RA2PS/Radio-Telescope-RAPS/README.md

# Radio-Telescope-RCA
Radio Telescope System for 1 GHz to 2 GHz Operation

> [!important]
> Make sure to add a KiCad path variable named "RADIO_TELESCOPE_RAPS_PATH"
> for the symbols and footprint to be found on your machine.
