RA2PS/Radio-Telescope-RAPS/KiCad PCB-Schematic/RCA Radio Telescope (MultiPCB)/KiKit Exports/RF Boards/MDF_PCB_Rev1-3/Models/142-0711-821.stp

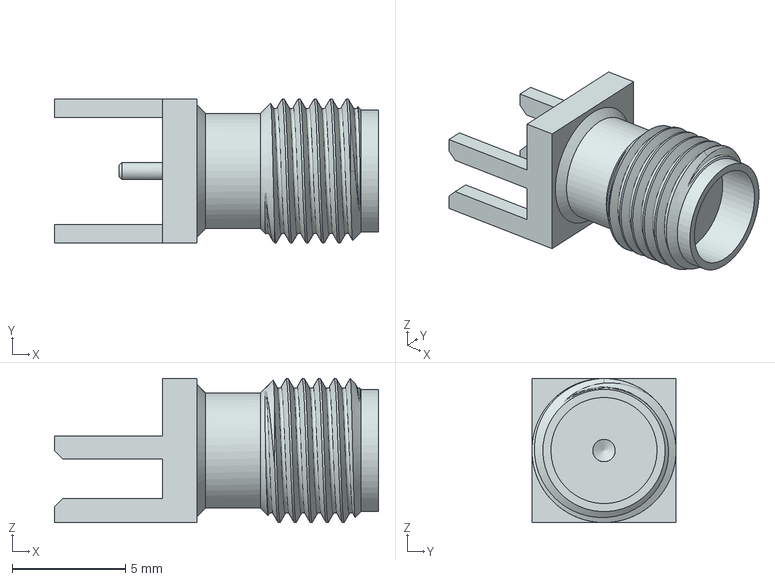
[picture p1: CAD file, 2026-05-28]
KiCad PCB-Schematic/RCA Radio Telescope (MultiPCB)/KiKit Exports/RF Boards/MDF_PCB_Rev1-3/Models/142-0711-821.stp
14.3 x 6.35 x 6.35 mm
