RA2PS/Radio-Telescope-RAPS/KiCad PCB-Schematic/RCA Radio Telescope (MultiPCB)/KiKit Exports/RF Boards/MDF_PCB_Rev1-3.step

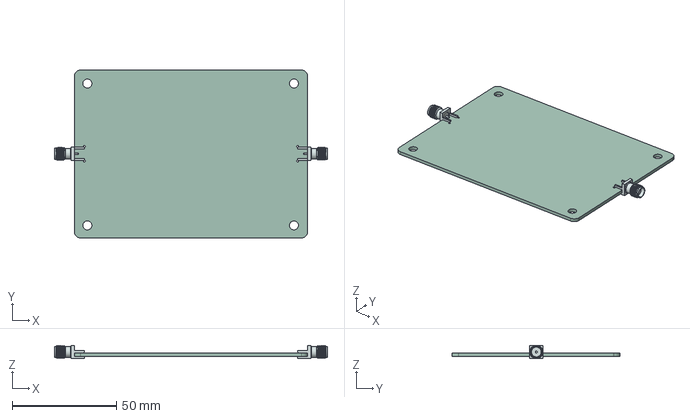
[picture p3: CAD file, 2026-05-28]
KiCad PCB-Schematic/RCA Radio Telescope (MultiPCB)/KiKit Exports/RF Boards/MDF_PCB_Rev1-3.step
130.8 x 80.5 x 6.35 mm
MDF_PCB_Rev1-3_PCB
