RA2PS/Radio-Telescope-RAPS/KiCad PCB-Schematic/RCA Radio Telescope (MultiPCB)/Models/SC-70_C5_MCH.step

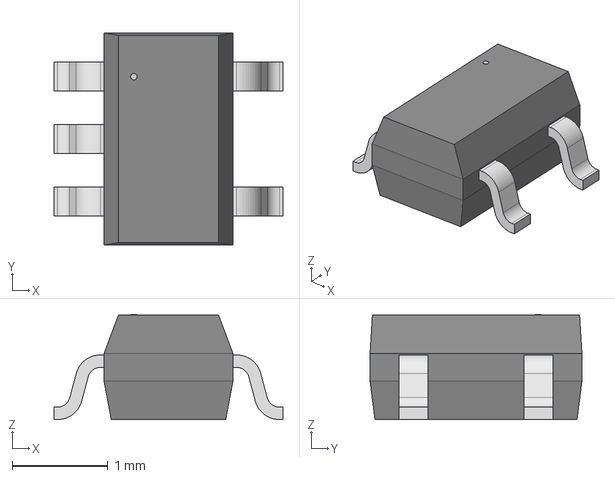
[picture p4: CAD file, 2026-05-28]
KiCad PCB-Schematic/RCA Radio Telescope (MultiPCB)/Models/SC-70_C5_MCH.step
2.39 x 2.21 x 1.09 mm
