RA2PS/Radio-Telescope-RAPS/KiCad PCB-Schematic/RCA Radio Telescope (MultiPCB)/KiKit Exports/RF Boards/MSF_PCB_Rev1-3.step

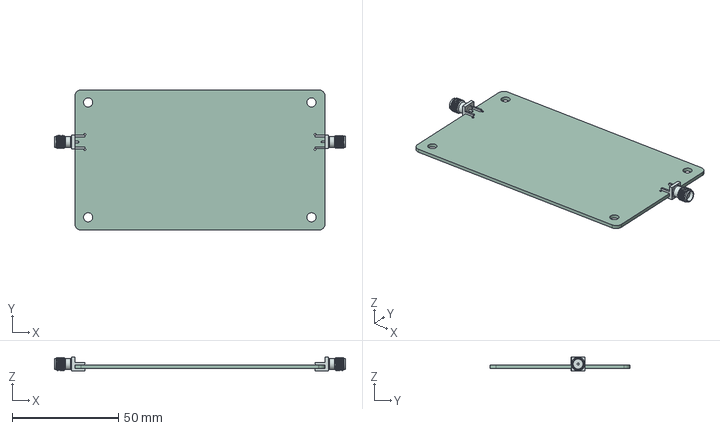
[picture p5: CAD file, 2026-05-28]
KiCad PCB-Schematic/RCA Radio Telescope (MultiPCB)/KiKit Exports/RF Boards/MSF_PCB_Rev1-3.step
136.8 x 66.0 x 6.35 mm
MSF_PCB_Rev1-3_PCB
