RA2PS/Radio-Telescope-RAPS/KiCad PCB-Schematic/RCA Radio Telescope (MultiPCB)/KiKit Exports/RF Boards/RFS_PCB_Rev1-4.step

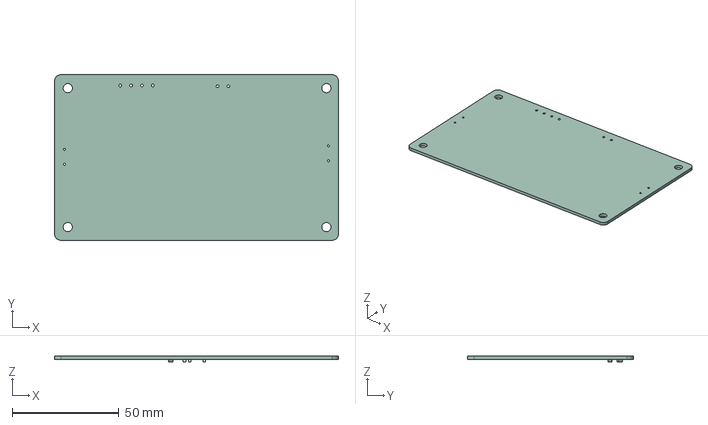
[picture p7: CAD file, 2026-05-28]
KiCad PCB-Schematic/RCA Radio Telescope (MultiPCB)/KiKit Exports/RF Boards/RFS_PCB_Rev1-4.step
132.9 x 77.5 x 2.90 mm
C_0805_2012Metric x 4
_autosave-RFS_PCB_Rev1-4_PCB
