RA2PS/Radio-Telescope-RAPS/KiCad PCB-Schematic/RCA Radio Telescope (MultiPCB)/Models/SMB_DIO.step

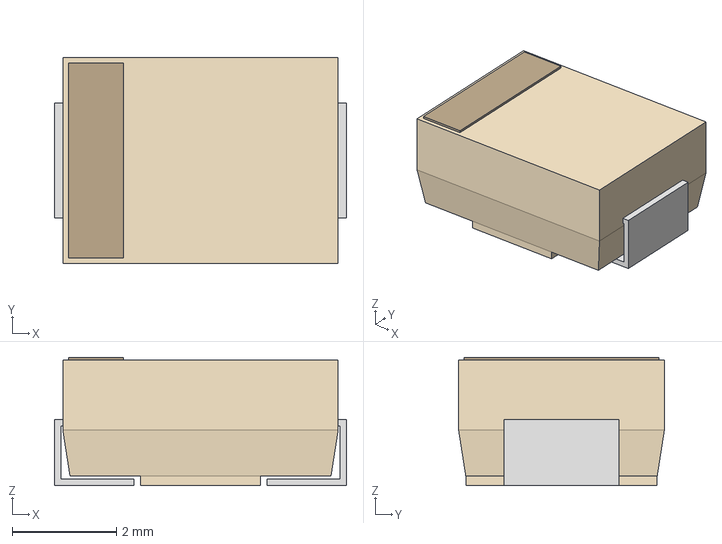
[picture p8: CAD file, 2026-05-28]
KiCad PCB-Schematic/RCA Radio Telescope (MultiPCB)/Models/SMB_DIO.step
5.59 x 3.94 x 2.45 mm
