RA2PS/Radio-Telescope-RAPS/KiCad PCB-Schematic/RCA Radio Telescope (MultiPCB)/Models/MIC5365-1.8YC5-TR.step

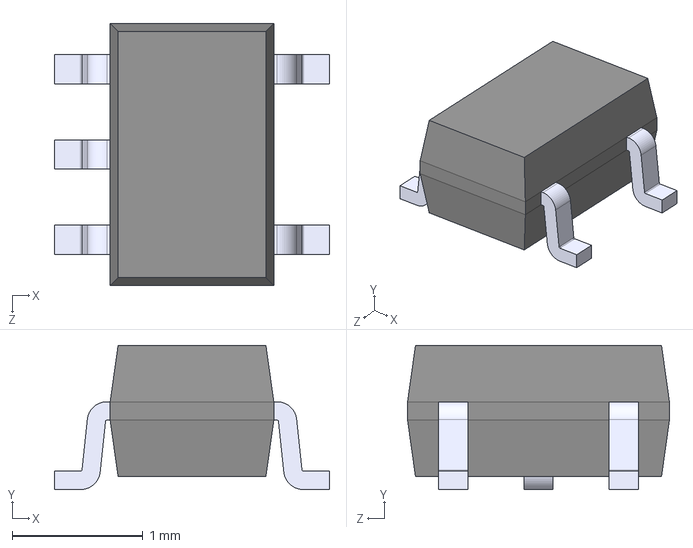
[picture p9: CAD file, 2026-05-28]
KiCad PCB-Schematic/RCA Radio Telescope (MultiPCB)/Models/MIC5365-1.8YC5-TR.step
2.10 x 1.10 x 2.00 mm
