RA2PS/Radio-Telescope-RAPS/KiCad PCB-Schematic/RCA Radio Telescope (MultiPCB)/Models/IND_CB_DRA73.step

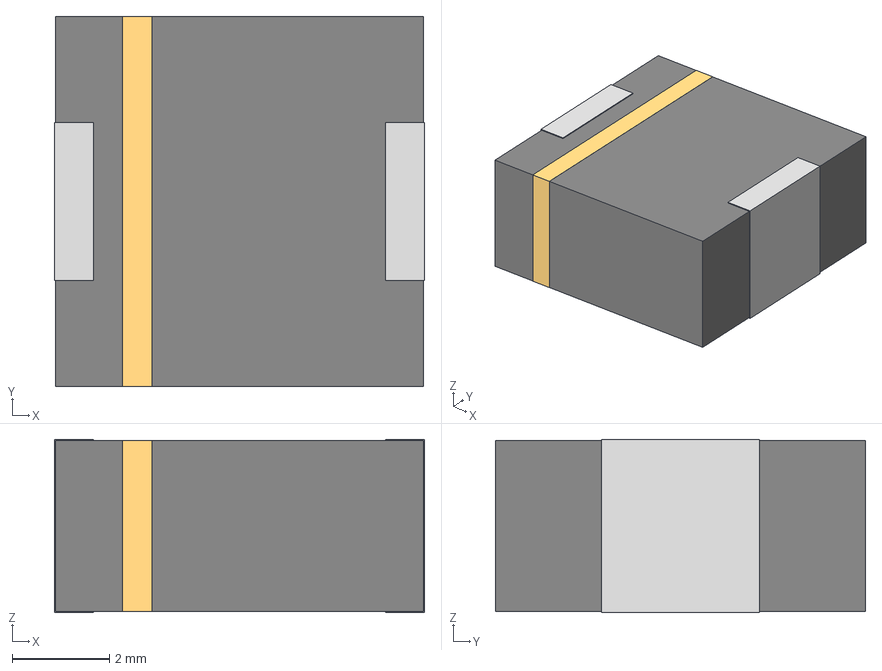
[picture p10: CAD file, 2026-05-28]
KiCad PCB-Schematic/RCA Radio Telescope (MultiPCB)/Models/IND_CB_DRA73.step
7.59 x 7.60 x 3.56 mm
