RA2PS/Radio-Telescope-RAPS/KiCad PCB-Schematic/RCA Radio Telescope (MultiPCB)/Models/MAX8510EXK30T.step

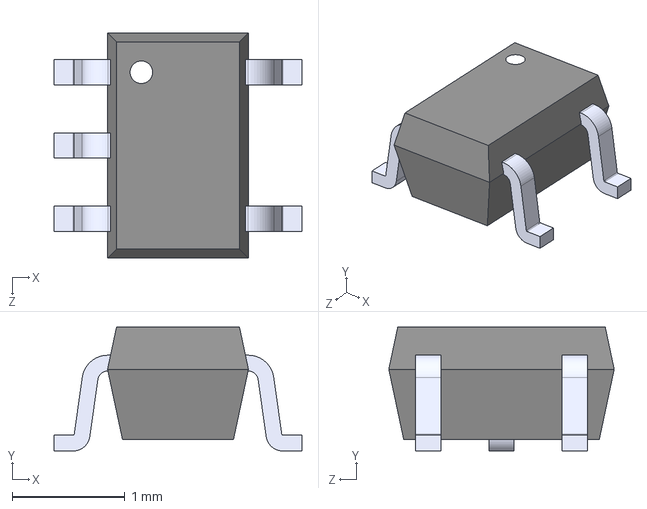
[picture p11: CAD file, 2026-05-28]
KiCad PCB-Schematic/RCA Radio Telescope (MultiPCB)/Models/MAX8510EXK30T.step
2.20 x 1.10 x 2.00 mm
