RA2PS/Radio-Telescope-RAPS/KiCad PCB-Schematic/RCA Radio Telescope (MultiPCB)/Models/RGT0016C.stp

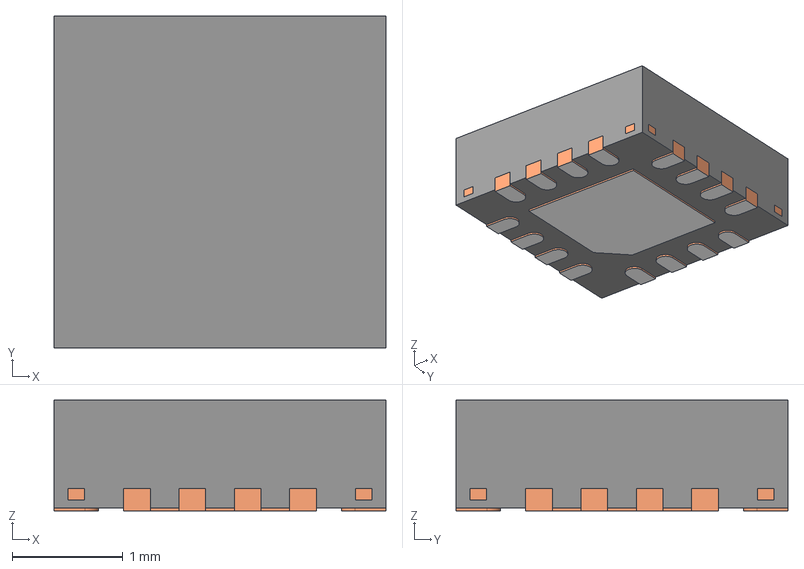
[picture p12: CAD file, 2026-05-28]
KiCad PCB-Schematic/RCA Radio Telescope (MultiPCB)/Models/RGT0016C.stp
3.00 x 3.00 x 1.00 mm
BODY-QFN
FRAME-RGT0016C
PIN1-ID
