RA2PS/Radio-Telescope-RAPS/KiCad PCB-Schematic/RCA Radio Telescope (MultiPCB)/Models/DFN2020E-6_STP.STP

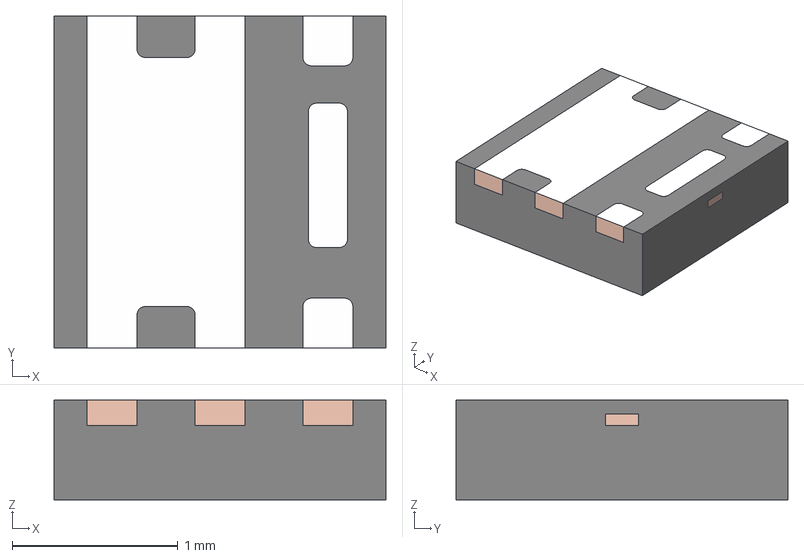
[picture p13: CAD file, 2026-05-28]
KiCad PCB-Schematic/RCA Radio Telescope (MultiPCB)/Models/DFN2020E-6_STP.STP
2.00 x 2.00 x 0.6 mm
Coumpound
LF
