RA2PS/Radio-Telescope-RAPS/(list of files, cad)

Other CAD files:
KiCad PCB-Schematic/RCA Radio Telescope (MultiPCB)/KiKit Exports/RF Boards/RFS_PCB_Rev1-3/Models/1729144.stp
KiCad PCB-Schematic/RCA Radio Telescope (MultiPCB)/Models/1729144.stp
