RA2PS/Radio-Telescope-RAPS/KiCad/smd_filter/smd_filter.kicad_pcb

## KiCad design KiCad/smd_filter/smd_filter.kicad_pcb (2026-10-02)

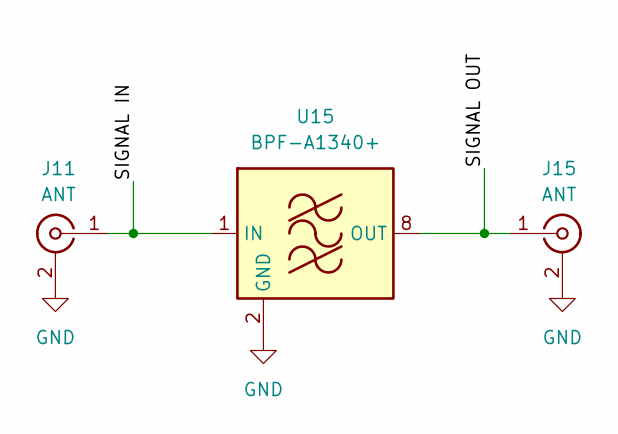
[picture p15: schematic smd_filter.kicad_sch]

Parts:
J11, J15: ANT; CONN_142-0711-821_CIN
U15: BPF-A1340+; Mini-Circuits_HQ1157

Connections:
/SMDFilter/GND: J11.2 (Ext), J15.2 (Ext), U15.2 (GND), U15.3 (GND), U15.4 (GND), U15.5 (GND), U15.6 (GND), U15.7 (GND), U15.9 (GND), U15.10 (GND), U15.11 (GND), U15.12 (GND), U15.13 (GND), U15.14 (GND)
/SMDFilter/SIGNAL_IN: J11.1 (In), U15.1 (IN)
/SMDFilter/SIGNAL_OUT: J15.1 (In), U15.8 (OUT)

Board: 2 copper layers, 3 parts (0 on the bottom side), 3 nets, no tracks yet.
