RA2PS/Radio-Telescope-RAPS/(commit log)

2026-05-28 Move BOM to a subdirectory and delete datasheets
    [Bill of Materials.xlsx]
2026-05-28 Copy each board to its own KiCad project
    [matched_distributive_filter.kicad_pcb, matched_distributive_filter.kicad_sch, matched_smd_filter.kicad_pcb, matched_smd_filter.kicad_sch, pwr_data_brd.kicad_pcb, pwr_data_brd.kicad_sch, rf_switch_filter.kicad_pcb, rf_switch_filter.kicad_sch]
2026-05-28 Fix power board symbols and nets, added project specific libs
    [pwr_data_brd.kicad_pcb, pwr_data_brd.kicad_sch]
2026-05-28 Fix filter symbols and labels, added project libraries
    [matched_distributive_filter.kicad_sch, matched_smd_filter.kicad_sch]
2026-05-28 Fix up RF switch project
    Laid out schematic to be more legible, added screw terminals from wiring
    diagram, changed GND symbols, changed labels to be global labels, and
    added project libraries
    [rf_switch_filter.kicad_pcb, rf_switch_filter.kicad_sch]
2026-10-02 Port over smd_filter
    [smd_filter.kicad_pcb, smd_filter.kicad_sch]
